Rdek113/rfr27-newmember-21/hardware/temperature_monitor_flowchart_diagram.pdf

# Temperature monitor: Flow Chart Diagram

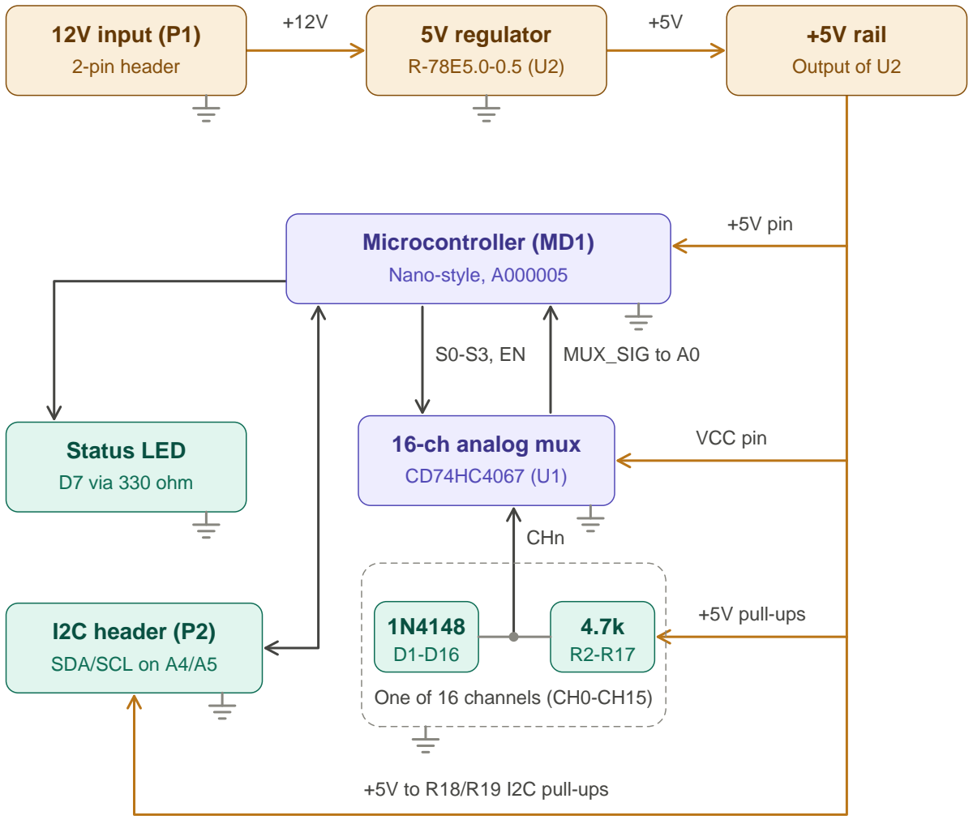
[picture p11: figure]
+5V pin; VCC pin; +5V pull-ups; +5V to R18/R19 I2C pull-ups; MUX_SIG to A0; CHn; 12V input (P1); 2-pin header; 5V regulator; +5V rail; Output of U2; Microcontroller (MD1); Nano-style, A000005; 16-ch analog mux; Status LED; D7 via 330 ohm; I2C header (P2); SDA/SCL on A4/A5; One of 16 channels (CH0-CH15)

Ground symbol: all tie to one common GND net
