Rdek113/rfr27-newmember-21/hardware/RFR New Member Project (Group #21) Hardware Design - FinalDraft#1.pdf

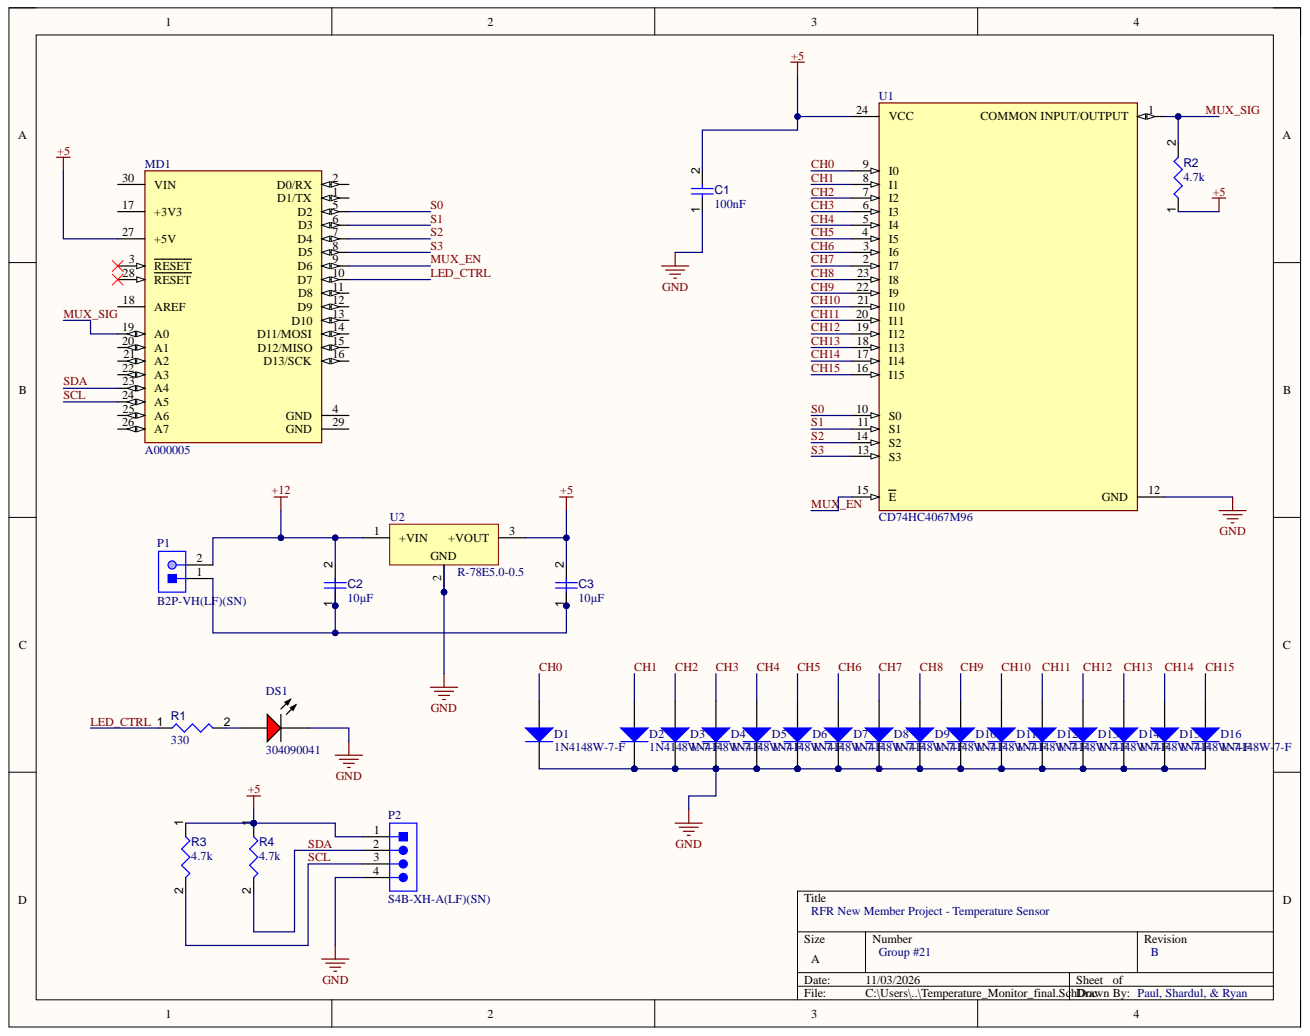
[picture p12: page 1]

SCL | 3

Title
RFR New Member Project - Temperature Sensor
