Rdek113/rfr27-newmember-21/hardware/SchematicVersion1.pdf

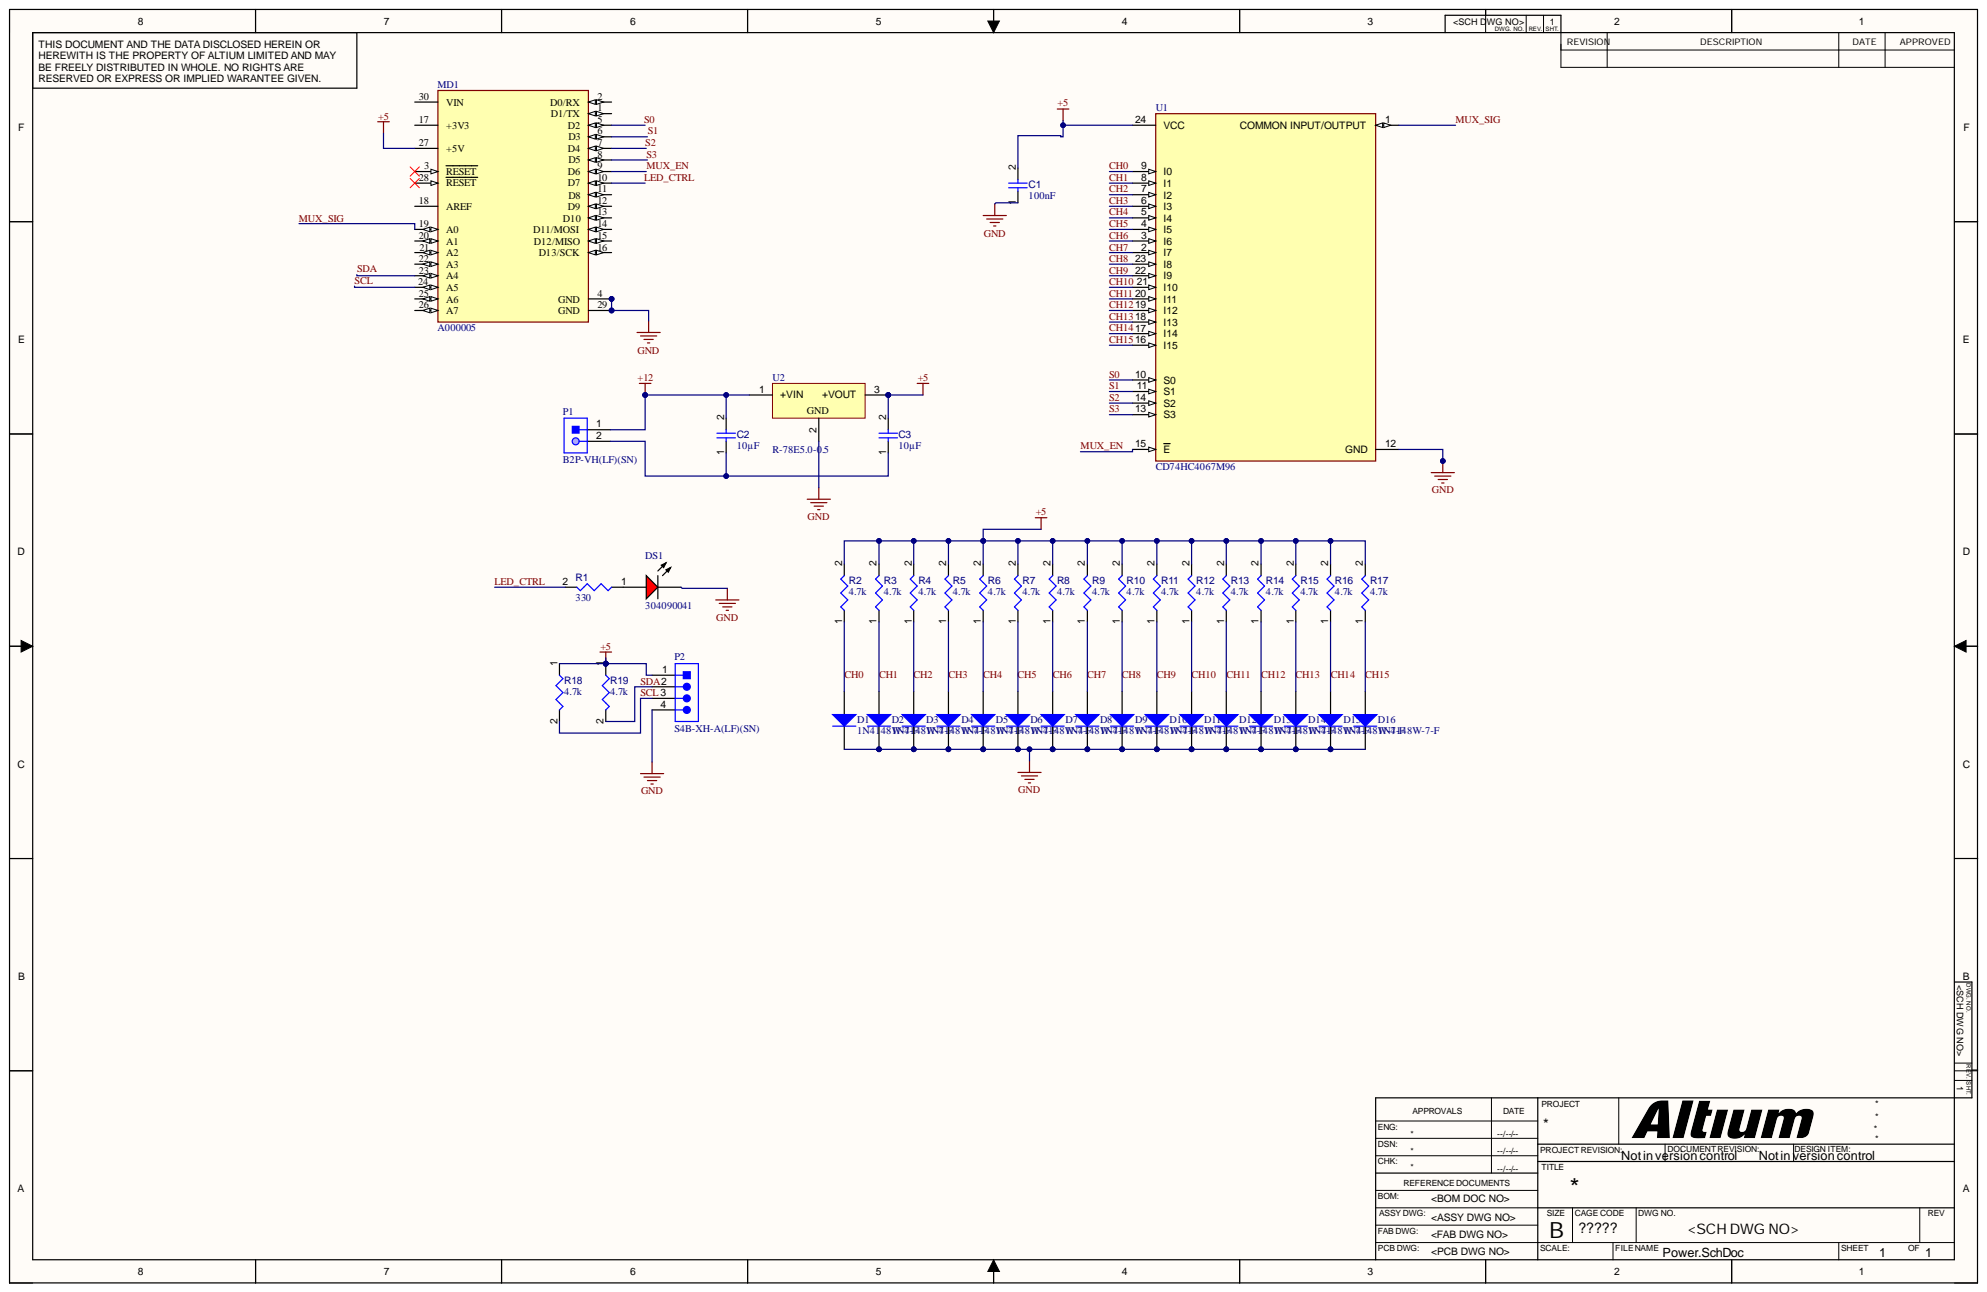
[picture p13: page 1]

8 | 7 | 6 | 5 | 4 | 3 | <SCH DWG NO> | DWG. NO. | REV. | 1 SHT. | 2 | 1

THIS DOCUMENT AND THE DATA DISCLOSED HEREIN OR HEREWITH IS THE PROPERTY OF ALTIUM LIMITED AND MAY BE FREELY DISTRIBUTED IN WHOLE. NO RIGHTS ARE RESERVED OR EXPRESS OR IMPLIED WARANTEE GIVEN. | MD1 | REVISION | DESCRIPTION | DATE | APPROVED

SCL | 3

REV. SHT. DWG. NO.

DATE | PROJECT * | * * APPROVALS * *

ENG: * | --/--/--

DSN: * | --/--/-- | PROJECT REVISION: Not in version control | DOCUMENT REVISION: Not in version control | DESIGN ITEM:

CHK: * | --/--/--
