Rdek113/rfr27-newmember-21/(list of files, drawings)

Other design files:
hardware/RFR New Member Project (Group #21) Hardware Design.PrjPcb
hardware/Temperature_Monitor.SchDoc
hardware/Temperature_Monitor_final.SchDoc
