Rdek113/rfr27-newmember-21/(commit log)

2026-10-15 Add hardware schematic flowchart v1
2026-11-03 Add files via upload
    Final Draft of Circuit, implementing changes specified by Jeevan and Vaanika - 11/03/26
2026-11-03 Add files via upload
    Updated schematic w/ changes from Jeevan and Vaanika part 1 - 11/03/26
    [Temperature_Monitor_final.SchDoc]
2026-11-04 Added revised temperature monitor design doc
2026-11-04 Switch temp conversion to linear interpolation and update design doc
